GoTouchGra55/GRAVITAS/JOURNAL.md

<!--
  This journal is auto generated by Stasis.
-->

# 5/10/2026 10 AM - Finish project

_Time spent: 9.5h_

After I lost my file, I absolutely speedran through this pcb. Cant believe that I did it in 9 hours. I say it looks better than last time. Now all that's left to do is to add some details and add bom + update the repo. Then, I'll submit this!

Screenshot from 2026-05-10 16-32-36

Screenshot from 2026-05-10 16-33-03

Screenshot from 2026-05-10 16-33-10





# 5/9/2026 9 AM - Lesson Learned

_Time spent: 3h_

I finished routing and decided to add bitmaps. But when  I added one to the converter, it looked suspiciously large. I thought nothing of it at first and added it to the pcb. Now the pcb does not open at all ;-; I'll probably have to reroute everything atp. fk me

Before you accuse me of not trying to retrieve it, lemme just tell you that 2 hours of my time were spent on the retrieval process and I got no success.

Screenshot from 2026-05-09 15-00-37

This was the finished pcb.
AURA




# 5/7/2026 3 PM - Routing

_Time spent: 3h_

I routed the imu, barometer, sd card socket and the pyro channels. Had to move some components to the bottom layer but I'll hand solder them so no extra pcba costs. 4 layers was a good idea bc I havent routed a single thing in the ground plane yet so hopefully it should have low [impedance](https://en.wikipedia.org/wiki/Electrical_impedance).

Now all that's left to do is to route the rf unit.

Screenshot from 2026-05-07 20-11-43

Screenshot from 2026-05-07 20-11-51

AURA





# 5/6/2026 11 AM - Initial Routing and Planning

_Time spent: 7h_

Worked on this the whole day! Although I'm not a huge fan of the current design, I'd say its pretty ok. I still have to plan the routes for the rf section so that will take a lot of time. Buttttt this much work must be good enough for today. I have an exam tomorrow btw ;-;

Screenshot from 2026-05-06 17-36-21

Screenshot from 2026-05-06 17-36-41




# 5/5/2026 11 AM - Footprint assignment

_Time spent: 0.5h_

I finally concluded the schematics! Footprint assignment was very straightforward. Went with mostly 0603 components because I want to hand solder some components like resistors and shii. Gonna start routing now. Need to do a quick ritual beforehand.

Screenshot from 2026-05-05 16-34-03

Screenshot from 2026-05-05 16-44-54




# 5/4/2026 10 AM - MCU Schematics

_Time spent: 1.5h_

Wired up everything based on cubemx. I also added servo headers and updated the pyro channels in the cubemx. I think I'm done with the schematics now. Time for footprint assignment!

Screenshot from 2026-05-04 16-39-13



# 5/3/2026 4 PM - MCU Schematics and indicators

_Time spent: 3.833333333333333h_

It wounldn't have taken this long if it weren't for my stupid headache. I basically added indicator leds for the external and internal (mcu) power supplies.
Screenshot from 2026-05-03 22-13-14

Here I added the decoupling capacitors and also the VDDA filtering circuit. I also found out that the stm32h7xxx mcus have more configurable pins like the exposed ADC VREF pin. I spent wayy to long on that damn datasheet for this mcu.

Screenshot from 2026-05-03 22-13-24




# 5/2/2026 8 AM - MCU Configuration

_Time spent: 2.25h_

I spent a fair amount of time configuring the mcu in cubemx. I used TIM1 for [TVC](https://en.wikipedia.org/wiki/Thrust_vectoring) servo [PWM](https://en.wikipedia.org/wiki/Pulse-width_modulation) generation. I also learned that there are reference manuals for each mcu on ST's website!
Now all that's left to be done is to connect my peripherals to the mcu based on this diagram. Then I can finally move onto the routing stage!

Screenshot from 2026-05-02 14-02-40

Screenshot from 2026-05-02 14-02-36




# 5/1/2026 3 PM - Telemetry Schematic

_Time spent: 6h_

### Turns out, I'm blind!
Early this morning, I sat down to wire up the sx1262 chip that I would be using for telemetry. I opened up the datasheet and read through and looked for wiring details. To my horror, I couldn't find the damn wiring diagram. So I googled it. Google gave me another datasheet but same issue. I then went on youtube and couldn't find anything. So I decided to watch some youtube videos on rf routing in hopes of getting some sort of idea on wiring up the schematic. Then I finally saw it; on the last pages of the datasheet. The authors decided to put the diagrams at last and all the electrical characteristics up top. But then I read through the table of contents, and saw the named page on wiring diagrams. My dumb ahh couldn't read that 5 hours ago. 
  
Screenshot from 2026-05-01 21-10-51



# 4/30/2026 8 AM - IMU

_Time spent: 0.4166666666666667h_

Nothing special here. Just followed through a datasheet  to wire the imu. Pretty simple to understand and configure the icm45686 chip. Although I went into a rabbit hole while trying to understand the pinout of the imu chip.

Screenshot from 2026-04-30 13-56-03

Screenshot from 2026-04-30 14-41-29




# 4/29/2026 10 AM - Power Supply

_Time spent: 1h_

Took a break yesterday but I'm back now. I basically wired up the 6v power supply for servos and any miscellaneous components that may require higher voltage and a 3.3v power supply for the lower voltage components. It was pretty straightforward to wire this up.

Screenshot from 2026-04-29 16-05-10



# 4/27/2026 12 PM - Pyro Channels

_Time spent: 1.5h_

Ok here me out-
I know that it looks like I input more time than required but it was the research that took the most time. I scoured through many resources (Somehow got blocked from [rocketryforum.com](rocketryforum.com) although I never accessed that site previously ;-;). But finally, I understood the logic behind the schematics for the pyro channel! I made the schematic sheet a bit prettier. 
Screenshot from 2026-04-27 18-04-59



# 4/25/2026 3 PM - Barometer Schematics

_Time spent: 0.5h_

This was pretty straightforward to do. Just read through the datasheet and learned the internals, then I did the schematics for a 4 wire SPI protocol
Screenshot from 2026-04-25 21-37-15



# 4/25/2026 12 PM - Schematics

_Time spent: 1h_

Screenshot from 2026-04-25 18-07-25

So yeah the schematics didnt take too long. The research did. I thought that the schematics were wrong for the model of the micro sd card that I was planning to use but turns out, after 40 minutes of research that this is completely compatible with what I had in mind
