GoTouchGra55/GRAVITAS/firmware/GRAVITAS.ioc

Mcu.UserName=STM32H743VITx
PA0.Signal=SDMMC2_CMD
PA1.GPIO_Label=GRID_CH2
PA1.Signal=S_TIM2_CH2
PA11.Signal=USB_OTG_FS_DM
PA12.Signal=USB_OTG_FS_DP
PA3.GPIO_Label=GRID_CH4
PA3.Signal=S_TIM2_CH4
PA4.GPIO_Label=IMU_CS
PA4.Signal=GPIO_Output
PA5.GPIO_Label=IMU_SCK
PA5.Signal=SPI1_SCK
PA6.GPIO_Label=IMU_MISO
PA6.Signal=SPI1_MISO
PA7.GPIO_Label=IMU_MOSI
PA7.Signal=SPI1_MOSI
PB10.GPIO_Label=GRID_CH3
PB10.Signal=S_TIM2_CH3
PB13.GPIO_Label=BMP_SCK
PB13.Signal=SPI2_SCK
PB14.Signal=SDMMC2_D0
PB15.Signal=SDMMC2_D1
PB2.GPIO_Label=SX_MOSI
PB2.Signal=SPI3_MOSI
PC0.GPIO_Label=BMP_CS
PC0.Signal=GPIO_Output
PC1.GPIO_Label=BMP_MOSI
PC1.Signal=SPI2_MOSI
PC10.GPIO_Label=SX_SCK
PC10.Signal=SPI3_SCK
PC11.GPIO_Label=SX_MISO
PC11.Signal=SPI3_MISO
PC12.GPIO_Label=SX_CS
PC12.Signal=GPIO_Output
PC2_C.GPIO_Label=BMP_MISO
PC2_C.Signal=SPI2_MISO
PC3_C.GPIO_Label=BMP_INT
PC3_C.Signal=GPXTI3
PC4.GPIO_Label=IMU_INT1
PC4.Signal=GPXTI4
PC5.GPIO_Label=IMU_INT2
PC5.Signal=GPXTI5
PC6.GPIO_Label=PYRO_CH1
PC6.Signal=GPIO_Output
PC7.GPIO_Label=PYRO_CH2
PC7.Signal=GPIO_Output
PC8.GPIO_Label=PYRO_CH3
PC8.Signal=GPIO_Output
PC9.GPIO_Label=PYRO_CH4
PC9.Signal=GPIO_Output
PD0.GPIO_Label=SX_NRST
PD0.Signal=GPIO_Output
PD1.GPIO_Label=SX_BUSY
PD1.Signal=GPIO_Input
PD6.Signal=SDMMC2_CK
PD7.GPIO_Label=SD_CD
PD7.Signal=GPIO_Input
PE11.GPIO_Label=TVC_CH2
PE11.Signal=S_TIM1_CH2
PE9.GPIO_Label=TVC_CH1
PE9.Signal=S_TIM1_CH1
