GoTouchGra55/GRAVITAS/firmware/Core/Inc/main.h

#define BMP_CS_Pin GPIO_PIN_0
#define BMP_CS_GPIO_Port GPIOC
#define BMP_MOSI_Pin GPIO_PIN_1
#define BMP_MOSI_GPIO_Port GPIOC
#define BMP_MISO_Pin GPIO_PIN_2
#define BMP_MISO_GPIO_Port GPIOC
#define BMP_INT_Pin GPIO_PIN_3
#define BMP_INT_GPIO_Port GPIOC
#define GRID_CH2_Pin GPIO_PIN_1
#define GRID_CH2_GPIO_Port GPIOA
#define GRID_CH4_Pin GPIO_PIN_3
#define GRID_CH4_GPIO_Port GPIOA
#define IMU_CS_Pin GPIO_PIN_4
#define IMU_CS_GPIO_Port GPIOA
#define IMU_SCK_Pin GPIO_PIN_5
#define IMU_SCK_GPIO_Port GPIOA
#define IMU_MISO_Pin GPIO_PIN_6
#define IMU_MISO_GPIO_Port GPIOA
#define IMU_MOSI_Pin GPIO_PIN_7
#define IMU_MOSI_GPIO_Port GPIOA
#define IMU_INT1_Pin GPIO_PIN_4
#define IMU_INT1_GPIO_Port GPIOC
#define IMU_INT2_Pin GPIO_PIN_5
#define IMU_INT2_GPIO_Port GPIOC
#define SX_MOSI_Pin GPIO_PIN_2
#define SX_MOSI_GPIO_Port GPIOB
#define TVC_CH1_Pin GPIO_PIN_9
#define TVC_CH1_GPIO_Port GPIOE
#define TVC_CH2_Pin GPIO_PIN_11
#define TVC_CH2_GPIO_Port GPIOE
#define GRID_CH3_Pin GPIO_PIN_10
#define GRID_CH3_GPIO_Port GPIOB
#define BMP_SCK_Pin GPIO_PIN_13
#define BMP_SCK_GPIO_Port GPIOB
#define PYRO_CH1_Pin GPIO_PIN_6
#define PYRO_CH1_GPIO_Port GPIOC
#define PYRO_CH2_Pin GPIO_PIN_7
#define PYRO_CH2_GPIO_Port GPIOC
#define PYRO_CH3_Pin GPIO_PIN_8
#define PYRO_CH3_GPIO_Port GPIOC
#define PYRO_CH4_Pin GPIO_PIN_9
#define PYRO_CH4_GPIO_Port GPIOC
#define GRID_CH1_Pin GPIO_PIN_15
#define GRID_CH1_GPIO_Port GPIOA
#define SX_SCK_Pin GPIO_PIN_10
#define SX_SCK_GPIO_Port GPIOC
#define SX_MISO_Pin GPIO_PIN_11
#define SX_MISO_GPIO_Port GPIOC
#define SX_CS_Pin GPIO_PIN_12
#define SX_CS_GPIO_Port GPIOC
#define SX_NRST_Pin GPIO_PIN_0
#define SX_NRST_GPIO_Port GPIOD
#define SX_BUSY_Pin GPIO_PIN_1
#define SX_BUSY_GPIO_Port GPIOD
#define SD_CD_Pin GPIO_PIN_7
#define SD_CD_GPIO_Port GPIOD
