GoTouchGra55/GRAVITAS/(commit log)

2026-08-18 Modularize drivers and send test whoami
2026-08-19 Read IMU data
2026-08-22 Fix readme
    [bom.csv, designators.csv, positions.csv]
